dj-bauer/espfancooling/fancontroller/fancontroller.kicad_pcb

## KiCad design fancontroller/fancontroller.kicad_pcb (2024-11-04)

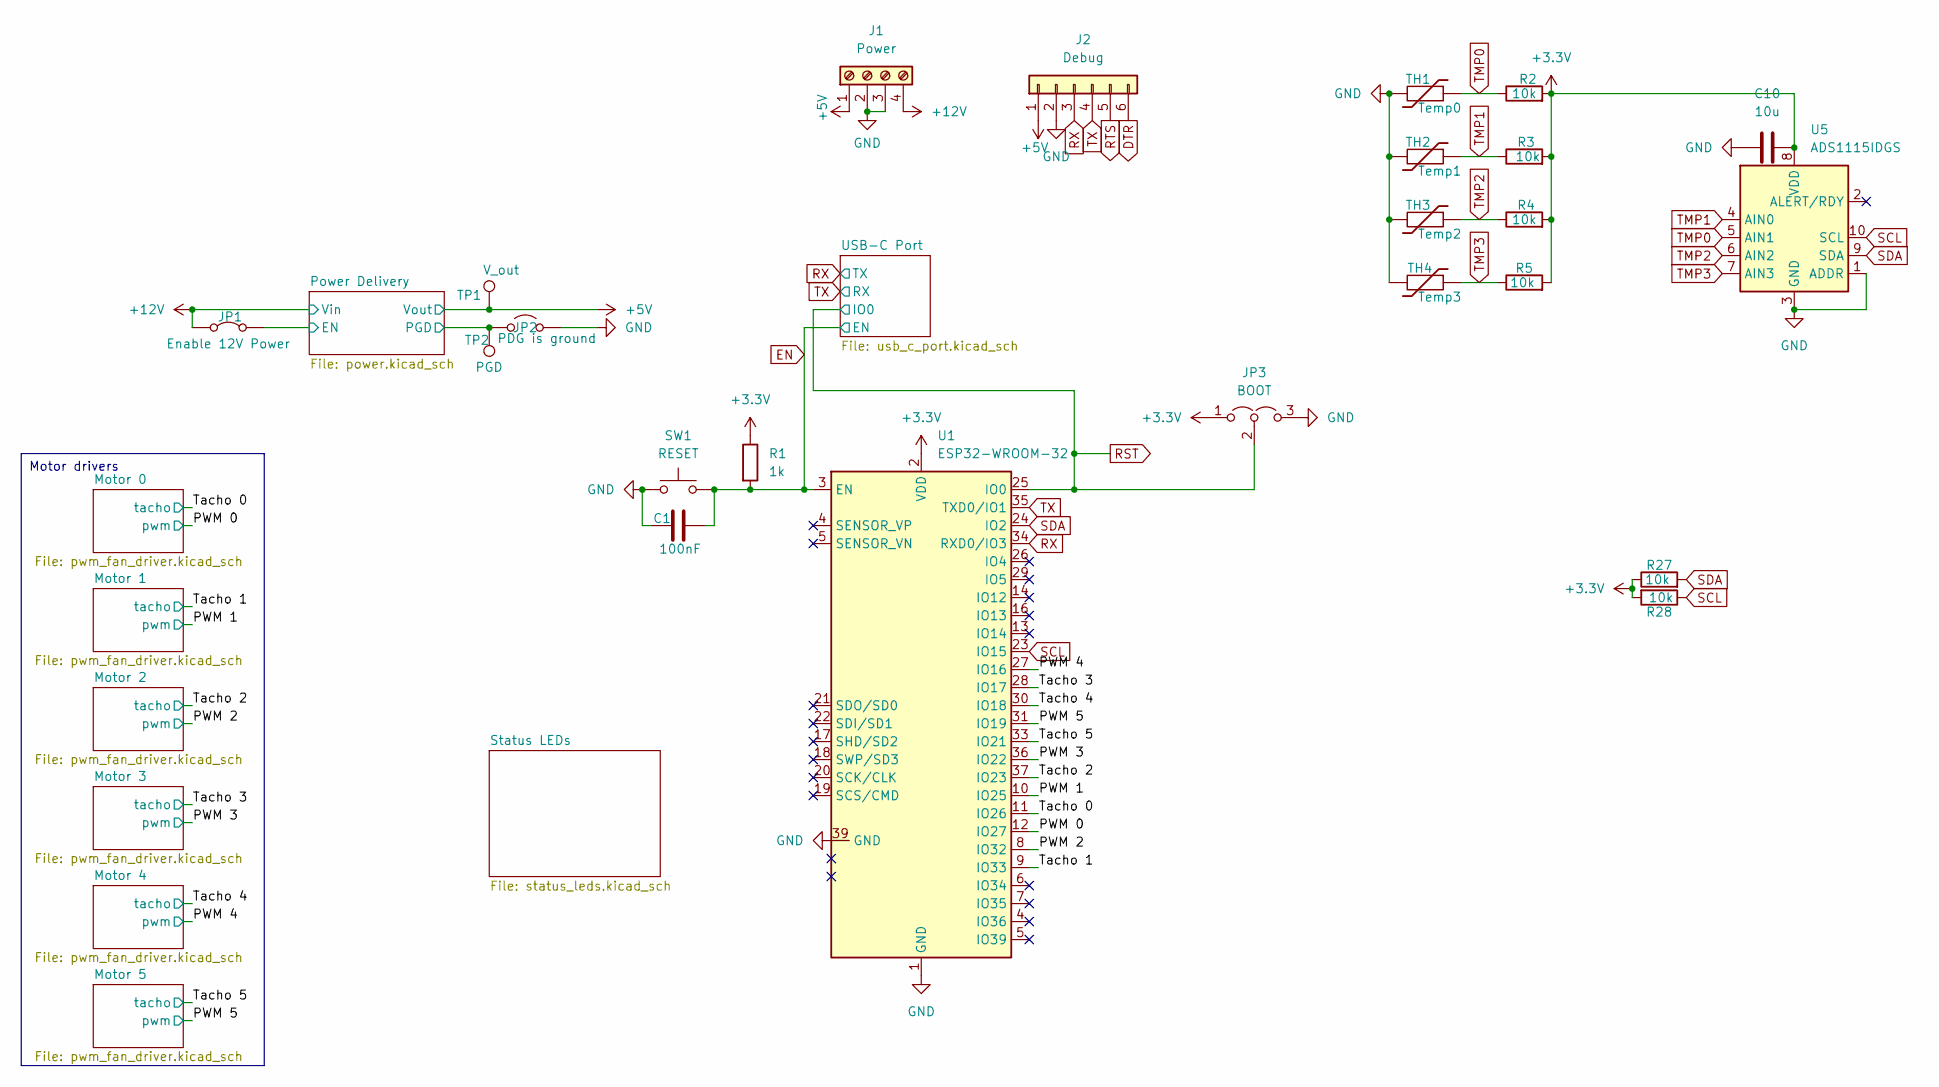
[picture p1: schematic fancontroller.kicad_sch, ESP-Fancontroller]

Parts:
C1: 100nF; C_0805_2012Metric; LCSC Part # C1525
C10: 10u
J1: Power; PinHeader_1x04_P2.54mm_Vertical; LCSC Part # C915913
J2: Debug; PinHeader_1x06_P2.54mm_Vertical; LCSC Part # C91552
JP1: Enable 12V Power; PinHeader_1x02_P2.54mm_Vertical; JLCPCB Rotation Offset 90
JP2: PDG is ground; PinHeader_1x02_P2.54mm_Vertical; JLCPCB Rotation Offset 90
JP3: BOOT; PinHeader_1x03_P2.54mm_Vertical; LCSC Part # C27985188
R1: 1k; R_0805_2012Metric; LCSC Part # C17513
R2, R3, R4, R5, R27, R28: 10k; R_0805_2012Metric; LCSC Part # C17414
SW1: RESET; PinHeader_1x02_P2.54mm_Vertical; LCSC Part # C5360898
TH1: Temp0; PinHeader_1x02_P2.54mm_Vertical; LCSC Part # C5360898
TH2: Temp1; PinHeader_1x02_P2.54mm_Vertical; LCSC Part # C5360898
TH3: Temp2; PinHeader_1x02_P2.54mm_Vertical; LCSC Part # C5360898
TH4: Temp3; PinHeader_1x02_P2.54mm_Vertical; LCSC Part # C5360898
TP1: V_out; TestPoint_Pad_2.5x2.5mm
TP2: PGD; TestPoint_Pad_2.5x2.5mm
U1: ESP32-WROOM-32; ESP32-WROOM-32E; LCSC Part # C2973652
U5: ADS1115IDGS; TSSOP-10_3x3mm_P0.5mm; LCSC Part # C37593

Connections:
+3.3V: C10.2, JP3.1 (A), R1.1, R2.2, R3.2, R4.2, R5.2, R27.1, R28.2, U1.2 (VDD), U5.8 (VDD); also elsewhere on the board
+5V: J1.1, J2.1, TP1.1; also elsewhere on the board
+12V: J1.4, JP1.1 (A); also elsewhere on the board
/PWM 0: U1.12 (IO27); also elsewhere on the board
/PWM 1: U1.10 (IO25); also elsewhere on the board
/PWM 2: U1.8 (IO32); also elsewhere on the board
/PWM 3: U1.36 (IO22); also elsewhere on the board
/PWM 4: U1.27 (IO16); also elsewhere on the board
/PWM 5: U1.31 (IO19); also elsewhere on the board
/Power Delivery/EN: JP1.2 (B); also elsewhere on the board
/Power Delivery/PGD: JP2.1 (A), TP2.1; also elsewhere on the board
/Tacho 0: U1.11 (IO26); also elsewhere on the board
/Tacho 1: U1.9 (IO33); also elsewhere on the board
/Tacho 2: U1.37 (IO23); also elsewhere on the board
/Tacho 3: U1.28 (IO17); also elsewhere on the board
/Tacho 4: U1.30 (IO18); also elsewhere on the board
/Tacho 5: U1.33 (IO21); also elsewhere on the board
DTR: J2.6; also elsewhere on the board
EN: C1.1, R1.2, SW1.2, U1.3 (EN); also elsewhere on the board
GND: C1.2, C10.1, J1.2, J1.3, J2.2, JP2.2 (B), JP3.3 (B), SW1.1, TH1.2, TH2.2, TH3.2, TH4.2, U1.1 (GND), U1.39 (GND), U5.1 (ADDR), U5.3 (GND); also elsewhere on the board
RST: JP3.2 (C), U1.25 (IO0); also elsewhere on the board
RTS: J2.5; also elsewhere on the board
RX: J2.3, U1.34 (RXD0/IO3); also elsewhere on the board
SCL: R28.1, U1.23 (IO15), U5.10 (SCL)
SDA: R27.2, U1.24 (IO2), U5.9 (SDA)
TMP0: R2.1, TH1.1, U5.5 (AIN1)
TMP1: R3.1, TH2.1, U5.4 (AIN0)
TMP2: R4.1, TH3.1, U5.6 (AIN2)
TMP3: R5.1, TH4.1, U5.7 (AIN3)
TX: J2.4, U1.35 (TXD0/IO1); also elsewhere on the board

Notes on the sheet:
Motor drivers

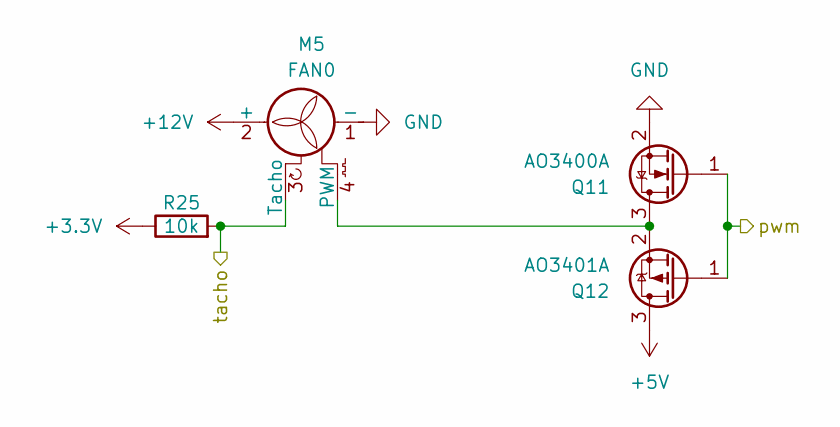
[picture p2: schematic pwm_fan_driver.kicad_sch, Intel PWM Motor driver]

Parts:
M5: FAN0; FanPinHeader_1x04_P2.54mm_Vertical; LCSC Part # C402778
Q11: AO3400A; SOT-23; LCSC Part # C20917
Q12: AO3401A; SOT-23; LCSC Part # C15127
R25: 10k; R_0805_2012Metric; LCSC Part # C17414

Connections:
+3.3V: R25.1; also elsewhere on the board
+5V: Q12.3 (D); also elsewhere on the board
+12V: M5.2 (+); also elsewhere on the board
/PWM 4: Q11.1 (G), Q12.1 (G); also elsewhere on the board
/Tacho 4: M5.3 (Tacho), R25.2; also elsewhere on the board
GND: M5.1 (-), Q11.2 (S); also elsewhere on the board
unnamed: M5.4 (PWM), Q11.3 (D), Q12.2 (S)

Parts of its further copies:
M1, M2, M3, M4, M6: FAN0; FanPinHeader_1x04_P2.54mm_Vertical; LCSC Part # C402778
Q3, Q5, Q7, Q9, Q13: AO3400A; SOT-23; LCSC Part # C20917
Q4, Q6, Q8, Q10, Q14: AO3401A; SOT-23; LCSC Part # C15127
R21, R22, R23, R24, R26: 10k; R_0805_2012Metric; LCSC Part # C17414

Connections of its further copies:
+3.3V: R21.1, R22.1, R23.1, R24.1, R26.1; also elsewhere on the board
+5V: Q4.3 (D), Q6.3 (D), Q8.3 (D), Q10.3 (D), Q14.3 (D); also elsewhere on the board
+12V: M1.2 (+), M2.2 (+), M3.2 (+), M4.2 (+), M6.2 (+); also elsewhere on the board
/PWM 0: Q5.1 (G), Q6.1 (G); also elsewhere on the board
/PWM 1: Q3.1 (G), Q4.1 (G); also elsewhere on the board
/PWM 2: Q7.1 (G), Q8.1 (G); also elsewhere on the board
/PWM 3: Q9.1 (G), Q10.1 (G); also elsewhere on the board
/PWM 5: Q13.1 (G), Q14.1 (G); also elsewhere on the board
/Tacho 0: M2.3 (Tacho), R22.2; also elsewhere on the board
/Tacho 1: M1.3 (Tacho), R21.2; also elsewhere on the board
/Tacho 2: M3.3 (Tacho), R23.2; also elsewhere on the board
/Tacho 3: M4.3 (Tacho), R24.2; also elsewhere on the board
/Tacho 5: M6.3 (Tacho), R26.2; also elsewhere on the board
GND: M1.1 (-), M2.1 (-), M3.1 (-), M4.1 (-), M6.1 (-), Q3.2 (S), Q5.2 (S), Q7.2 (S), Q9.2 (S), Q13.2 (S); also elsewhere on the board
unnamed: M1.4 (PWM), Q3.3 (D), Q4.2 (S)
unnamed: M2.4 (PWM), Q5.3 (D), Q6.2 (S)
unnamed: M3.4 (PWM), Q7.3 (D), Q8.2 (S)
unnamed: M4.4 (PWM), Q9.3 (D), Q10.2 (S)
unnamed: M6.4 (PWM), Q13.3 (D), Q14.2 (S)

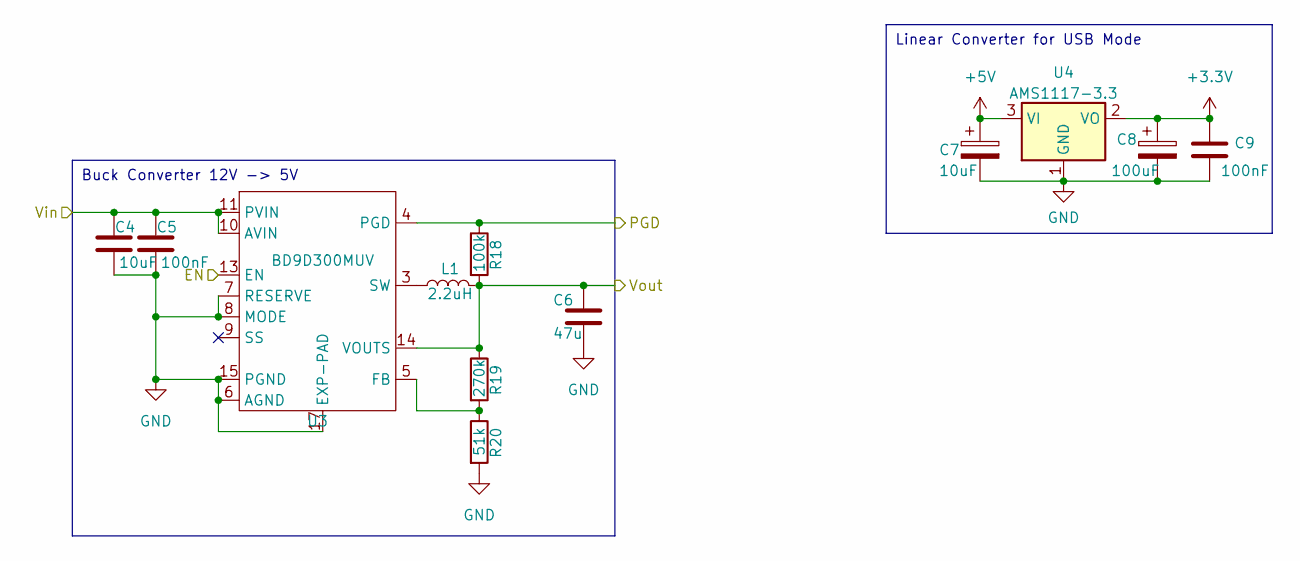
[picture p3: schematic power.kicad_sch, Power Circuit]

Parts:
C4, C7: 10uF; C_0805_2012Metric; LCSC Part # C440198
C5, C9: 100nF; C_0805_2012Metric; LCSC Part # C1525
C6: 47u; C_0805_2012Metric; LCSC Part # C16780
C8: 100uF; CP_Elec_10x10; LCSC Part # C249836
L1: 2.2uH; L_0805_2012Metric; LCSC Part # C479919
R18: 100k; R_0805_2012Metric; LCSC Part # C149504
R19: 270k; R_0805_2012Metric; LCSC Part # C17589
R20: 51k; R_0805_2012Metric; LCSC Part # C17737
U3: BD9D300MUV; VQFN-16-1EP_3x3mm_P0.5mm_EP1.45x1.45mm; LCSC Part # C2071880
U4: AMS1117-3.3; SOT-223; LCSC Part # C6186

Connections:
+3.3V: C8.1, C9.1, U4.2 (VO); also elsewhere on the board
+5V: C6.1, C7.1, L1.2, R18.2, R19.1, U3.14 (VOUTS), U4.3 (VI); also elsewhere on the board
+12V: C4.1, C5.1, U3.10 (AVIN), U3.11 (PVIN), U3.12 (PVIN); also elsewhere on the board
/Power Delivery/EN: U3.13 (EN); also elsewhere on the board
/Power Delivery/PGD: R18.1, U3.4 (PGD); also elsewhere on the board
GND: C4.2, C5.2, C6.2, C7.2, C8.2, C9.2, R20.2, U3.6 (AGND), U3.7 (RESERVE), U3.8 (MODE), U3.15 (PGND), U3.16 (PGND), U3.17 (EXP-PAD), U4.1 (GND); also elsewhere on the board
unnamed: L1.1, U3.1 (SW), U3.2 (SW), U3.3 (SW)
unnamed: R19.2, R20.1, U3.5 (FB)

Notes on the sheet:
Buck Converter 12V -> 5V
Linear Converter for USB Mode

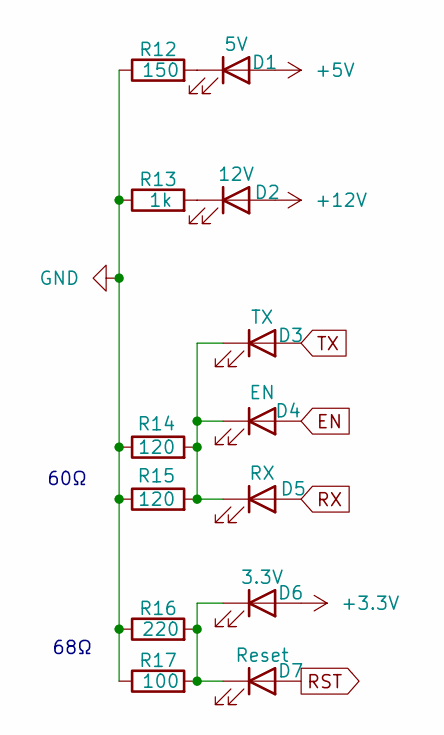
[picture p4: schematic status_leds.kicad_sch, Status LED batch]

Parts:
D1: 5V; LED_0805_2012Metric; LCSC Part # C84262
D2: 12V; LED_0805_2012Metric; LCSC Part # C84256
D3: TX; LED_0805_2012Metric; LCSC Part # C84257
D4: EN; LED_0805_2012Metric; LCSC Part # C84257
D5: RX; LED_0805_2012Metric; LCSC Part # C84257
D6: 3.3V; LED_0805_2012Metric; LCSC Part # C84262
D7: Reset; LED_0805_2012Metric; LCSC Part # C84262
R12: 150; R_0805_2012Metric; LCSC Part # C17471
R13: 1k; R_0805_2012Metric; LCSC Part # C17513
R14, R15: 120; R_0805_2012Metric; LCSC Part # C17437
R16: 220; R_0603_1608Metric; LCSC Part # C17557
R17: 100; R_0603_1608Metric; LCSC Part # C17408

Connections:
+3.3V: D6.2 (A); also elsewhere on the board
+5V: D1.2 (A); also elsewhere on the board
+12V: D2.2 (A); also elsewhere on the board
EN: D4.2 (A); also elsewhere on the board
GND: R12.1, R13.1, R14.1, R15.1, R16.1, R17.1; also elsewhere on the board
unnamed: D1.1 (K), R12.2
unnamed: D2.1 (K), R13.2
unnamed: D3.1 (K), D4.1 (K), D5.1 (K), R14.2, R15.2
unnamed: D6.1 (K), D7.1 (K), R16.2, R17.2
RST: D7.2 (A); also elsewhere on the board
RX: D5.2 (A); also elsewhere on the board
TX: D3.2 (A); also elsewhere on the board

Notes on the sheet:
68Ω
60Ω

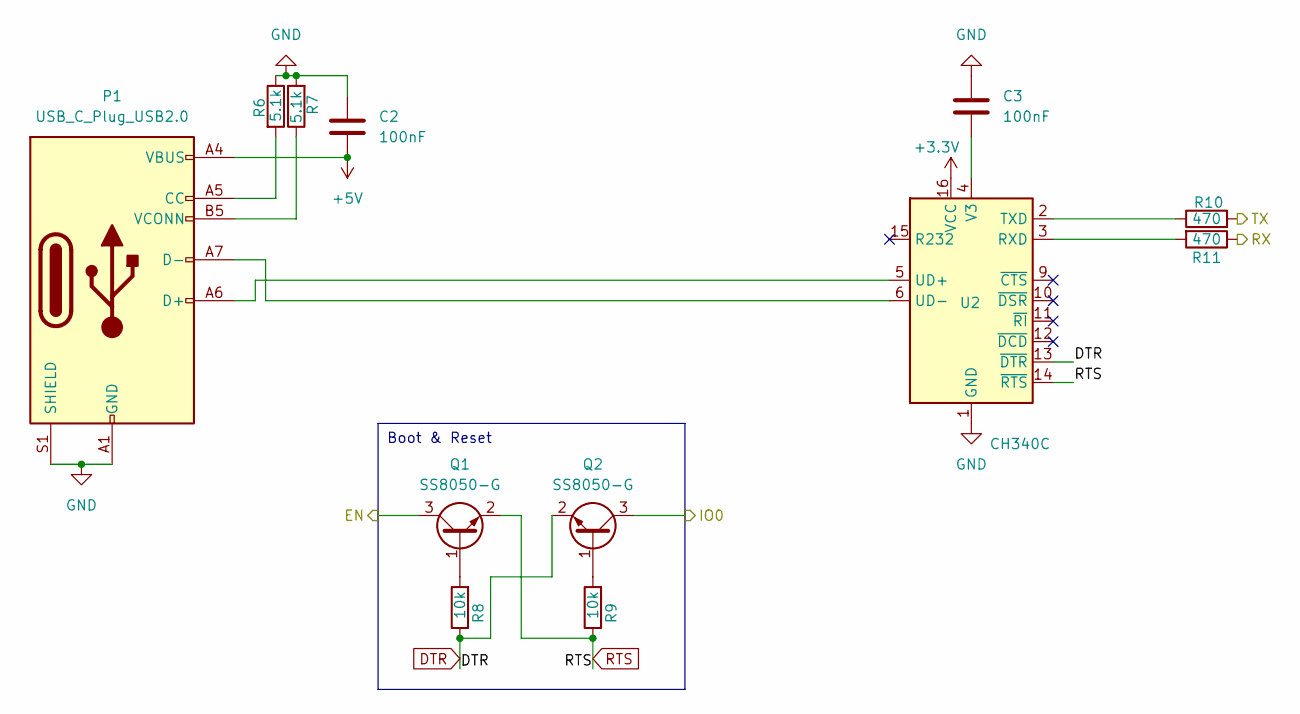
[picture p5: schematic usb_c_port.kicad_sch, USB-C Serial Port]

Parts:
C2, C3: 100nF; C_0805_2012Metric; LCSC Part # C1525
P1: USB_C_Plug_USB2.0; USB_C_Receptacle_HCTL_HC-TYPE-C-16P-01A; LCSC Part # C2894897
Q1, Q2: SS8050-G; SOT-23; LCSC Part # C2150
R6, R7: 5.1k; R_0805_2012Metric; LCSC Part # C27834
R8, R9: 10k; R_0805_2012Metric; LCSC Part # C17414
R10, R11: 470; R_0805_2012Metric; LCSC Part # C17710
U2: CH340C; SOIC-16_3.9x9.9mm_P1.27mm; LCSC Part # C84681

Connections:
+3.3V: U2.16 (VCC); also elsewhere on the board
+5V: C2.2, P1.A4 (VBUS), P1.A9 (VBUS), P1.B4 (VBUS), P1.B9 (VBUS); also elsewhere on the board
DTR: Q2.2 (E), R8.1, U2.13 (~DTR); also elsewhere on the board
EN: Q1.3 (C); also elsewhere on the board
GND: C2.1, C3.1, P1.A1 (GND), P1.A12 (GND), P1.B1 (GND), P1.B12 (GND), P1.S1 (SHIELD), R6.1, R7.2, U2.1 (GND); also elsewhere on the board
unnamed: P1.A5 (CC), R6.2
unnamed: P1.A6 (D+), U2.5 (UD+)
unnamed: P1.A7 (D-), U2.6 (UD-)
unnamed: P1.B5 (VCONN), R7.1
unnamed: Q1.1 (B), R8.2
unnamed: Q2.1 (B), R9.2
unnamed: R11.2, U2.3 (RXD)
unnamed: R10.1, U2.2 (TXD)
unnamed: C3.2, U2.4 (V3)
RST: Q2.3 (C); also elsewhere on the board
RTS: Q1.2 (E), R9.1, U2.14 (~RTS); also elsewhere on the board
RX: R10.2; also elsewhere on the board
TX: R11.1; also elsewhere on the board

Notes on the sheet:
Boot & Reset

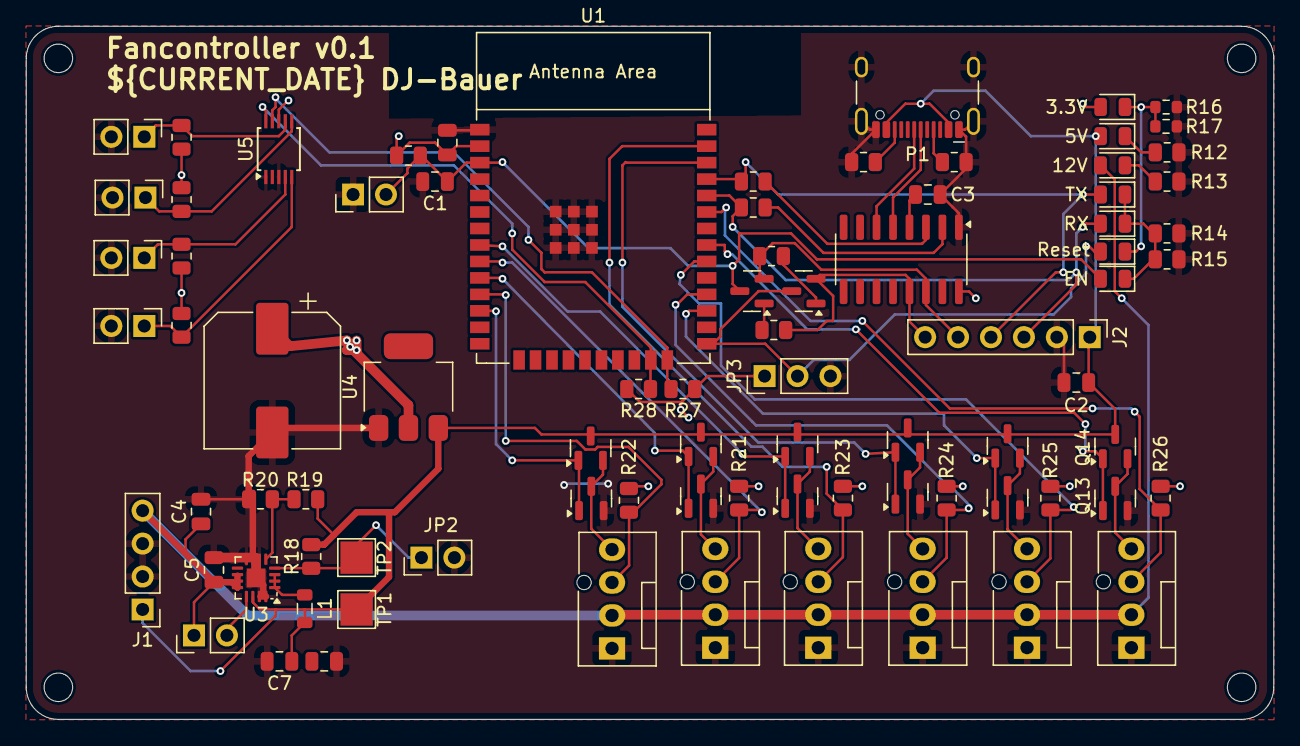
[picture p6: board fancontroller.kicad_pcb from above]

Board: 2 copper layers, 96.2 x 53.4 mm, 88 parts (1 on the bottom side), 51 nets.

Other parts of the board:
GNU: Symbol_GNU-Logo_SilkscreenTop
H1, H2, H3, H4: MountingHole_2.2mm_M2
