dj-bauer/espfancooling/(commit log)

2024-04-17 Kicad Projekt angelegt
    [fancontroller.kicad_pcb, fancontroller.kicad_sch]
2024-04-26 KIcad messing
    [fancontroller.kicad_sch]
2024-05-15 Auf esp32 festlegen und schematik anfangen
    [fancontroller.kicad_sch]
2024-05-22 Massiver Fortschritt. Die Schematik scheint fertig zu sein und das tracing hat begonnen. Schritt für schritt werden Label von io vertauscht, um das tracen zu vereinfachen
    [fancontroller.kicad_pcb, fancontroller.kicad_sch, pwm_driver.kicad_sch]
2024-05-24 First pcb iteration done
    [fancontroller.kicad_pcb, fancontroller.kicad_sch]
2024-05-25 Update pcb
    [fancontroller.kicad_pcb]
2024-05-29 FInish routing
    [fancontroller.kicad_pcb]
2024-09-28 CMOS treiber für PWM output hinzugefügt, sicher ist sicher und extern pullup widerstände für Tacho inputs. Die sollten alle Teile für den ersten Prototypen sein.
    PCB Layout muss angepasst werden und neu geroutet werden. Danach ready für ersten prototypen :)
    [fancontroller.kicad_pcb, fancontroller.kicad_sch]
2024-09-30 Routing für ersten prototypen fertig und erste Teilnummern Parts zugeordnet für assembly preview
    [fancontroller.kicad_pcb, fancontroller.kicad_sch]
2024-10-02 JLCPCB order rotations fixed for most parts
    [fancontroller.kicad_pcb, fancontroller.kicad_sch]
2024-10-07 prepare to start dev on v1.2
    [fancontroller.kicad_pcb, fancontroller.kicad_sch]
2024-10-07 Break up into schematics and add USB-C programming interface
    [fancontroller.kicad_sch, motor_pwm.kicad_sch, power.kicad_sch, status_leds.kicad_sch, usb_c_port.kicad_sch]
2024-10-07 Restructure Fan drivers into separate modules and rework USB-C
    [fancontroller.kicad_sch, power.kicad_sch, pwm_fan_driver.kicad_sch, status_leds.kicad_sch, usb_c_port.kicad_sch]
2024-10-07 Improve footprints and do massive overhaul for part numbering for better future order
    [fancontroller.kicad_pcb, fancontroller.kicad_sch, power.kicad_sch, pwm_fan_driver.kicad_sch, status_leds.kicad_sch, usb_c_port.kicad_sch]
2024-10-07 Pretty rounded edgecut around pcb and start laying out LEDs
    [fancontroller.kicad_pcb]
2024-10-08 Begin placing parts for v0.1 layout
    [fancontroller.kicad_pcb, fancontroller.kicad_sch]
2024-10-20 edit schematic
    [fancontroller.kicad_pcb, fancontroller.kicad_sch, power.kicad_sch]
2024-11-04 Add i2c ADC
    [fancontroller.kicad_pcb, fancontroller.kicad_sch]
